schnommus/orangecrab-hardware/(commit log)

2023-10-27 fix symbol links // try pcb/sch align
    [DECOUPLING.kicad_sch, DRAM.kicad_sch, FPGA.kicad_sch, IO.kicad_sch, OrangeCrab.kicad_pcb, OrangeCrab.kicad_sch, POWER.kicad_sch, SDMMC.kicad_sch]
2023-10-27 all IO gone/cleaned
    [DRAM.kicad_sch, FPGA.kicad_sch, IO.kicad_sch, OrangeCrab.kicad_pcb, OrangeCrab.kicad_sch, POWER.kicad_sch, SDMMC.kicad_sch]
2023-10-27 more gnd/via cleanup
    [OrangeCrab.kicad_pcb]
2023-10-28 M.2 form factor
    [CONNECTOR.kicad_sch, DRAM.kicad_sch, OrangeCrab.kicad_pcb, OrangeCrab.kicad_sch]
2023-10-28 connect all spare IOs to M.2
    [CONNECTOR.kicad_sch, DRAM.kicad_sch, FPGA.kicad_sch, OrangeCrab.kicad_pcb]
2023-10-28 Clean up DRC a bit
    [CONNECTOR.kicad_sch, DRAM.kicad_sch, OrangeCrab.kicad_pcb]
2023-10-28 dogbone out all FPGA IOs
    [OrangeCrab.kicad_pcb]
2023-10-28 almost finished route bank0 without pinswap
    [OrangeCrab.kicad_pcb]
2023-10-28 route done except final pinswap
    [OrangeCrab.kicad_pcb]
2023-10-28 execute pinswap, not routed yet
    [CONNECTOR.kicad_sch, DRAM.kicad_sch, OrangeCrab.kicad_pcb]
2023-10-28 complete route, clear all DRC violations
    [OrangeCrab.kicad_pcb]
2023-10-28 Clean up traces and silk
    [OrangeCrab.kicad_pcb]
2023-10-29 add some LCSC part numbers, stock all important parts
    [CONNECTOR.kicad_sch, DECOUPLING.kicad_sch, DRAM.kicad_sch, FPGA.kicad_sch, POWER.kicad_sch]
2023-11-08 route JTAG to M.2 pads
    [CONNECTOR.kicad_sch, DRAM.kicad_sch, OrangeCrab.kicad_pcb]
2023-11-08 populate LCSC# for missing passives
    [DRAM.kicad_sch, FPGA.kicad_sch, POWER.kicad_sch]
